alicedb2/tinyQuan/tinyQuan.sch

## KiCad design tinyQuan.sch (2021-08-04, last stored version)

Schematic: tinyQuan.sch

Parts:
A1: Arduino_Nano
C1, C2, C4, C6: 10nF
C3, C5: 100nF
J1: TRIGGER-OUT-Jack
J2: CVin-JACK
J3: CVout-Jack
R1, R2, R3, R4, R5, R6, R7, R8, R9, R10, R11, R12, R13: 10K
RV1: R12/R23=3
SW1: ROOT-RotEncSwitch
SW2: SCALE-RotEncSwitch
U1: LM317
U2: ADS1115; TSSOP-10_3x3mm_P0.5mm
U3: MCP4725; SOT-23-6
U4: SSD1306

Notes on the sheet:
In tune mode, set DAC to 4095 and trim RV1 such that U3’s VOUT is as close to 5.000V as possible Although not ideal you can also directly trim RV1 such that U1’s VO is as close to 5.000V as possible
