alicedb2/tinyQuan/(commit log)

2021-07-01 bug fix in in_scale_cv_mode
    [tinyQuan.ino]
2021-07-02 fixed scale and its spelling
    [definitions.h]
2021-07-02 change button code for a switch, no debouncing nightmare
2021-07-15 fixed scale names, lowered ADCmax
    [definitions.h]
2021-08-03 new tuning with regulator at 5V
2021-08-03 fixed bug in root change. simplified in_scale_cv_mode.
    [definitions.h, tinyQuan.ino]
2021-08-04 details and BOM
2021-08-04 kicad schematics
    [tinyQuan.sch]
2021-08-04 schematics image
2021-08-04 0v root
2021-08-04 pulled-up switches, tied-up unused pins
2021-08-04 missed a couple 1Ks, updated BOM
2021-08-04 typo in BOM
2021-08-04 i2c comments
2021-08-04 A0/ADDR to ground
2021-08-08 fixed trigger pin name
    [definitions.h, tinyQuan.ino]
